SandroGrassia/Belle-Iloise/README.md

# Belle-Iloise
### Project for a midi Talking Drum

this midi controller, that I made in 2017, is designed to be used as a talking drum.
Sound is triggered by tapping on the round pad, the pitch is modulated by squeezing the clothespin.
On the top side, three knobs control the central note, the pitch span and the volume. On the bottom side there is the on/off switch and the MIDI-OUT socket.
The device is powered by two 2x1.5V AA batteries; a small voltage regulator steps the voltage up to 5V required by the circuit.

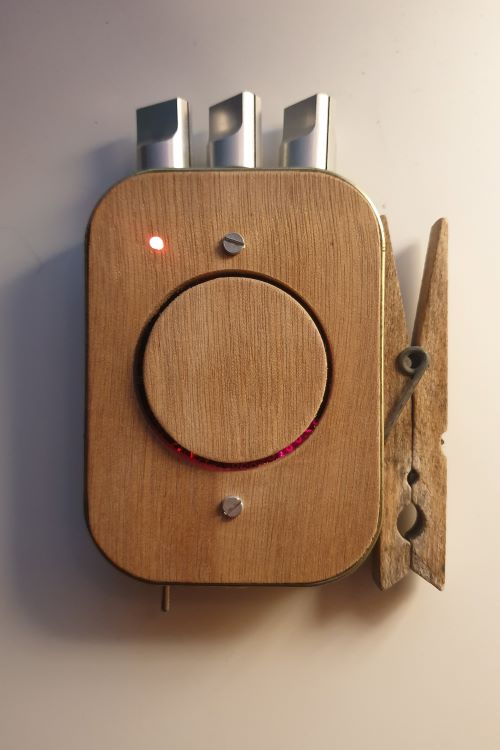
[picture p1: pics/fronte.jpg]


The name comes from the metal case branded "la belle-iloise".

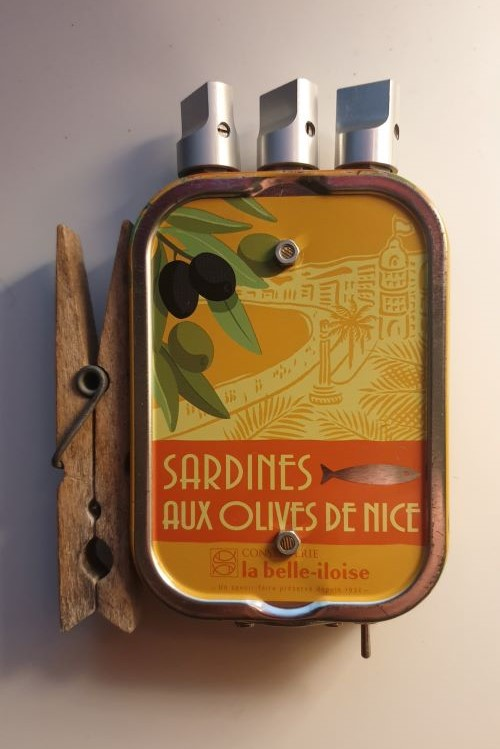
[picture p2: pics/retro.jpg]


This Belle-Iloise was the second piece/version I made, more compact than the previous one; the assembly is very artisanal... And a little bit messy!

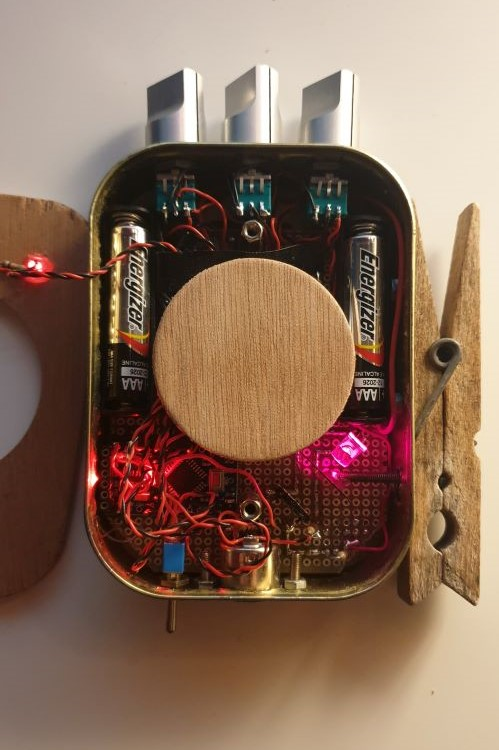
[picture p3: pics/inside.jpg]


This picture shows the Arduino Mini, the small board without USB port, based on an ATmega328P.

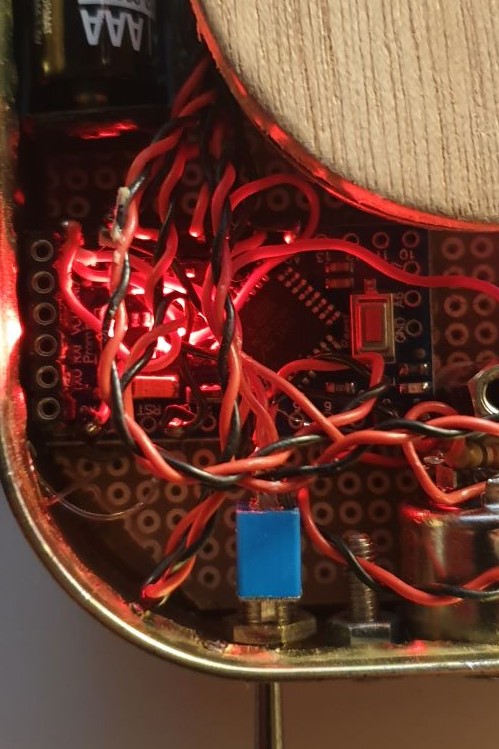
[picture p4: pics/mini.jpg]


*Schematics*

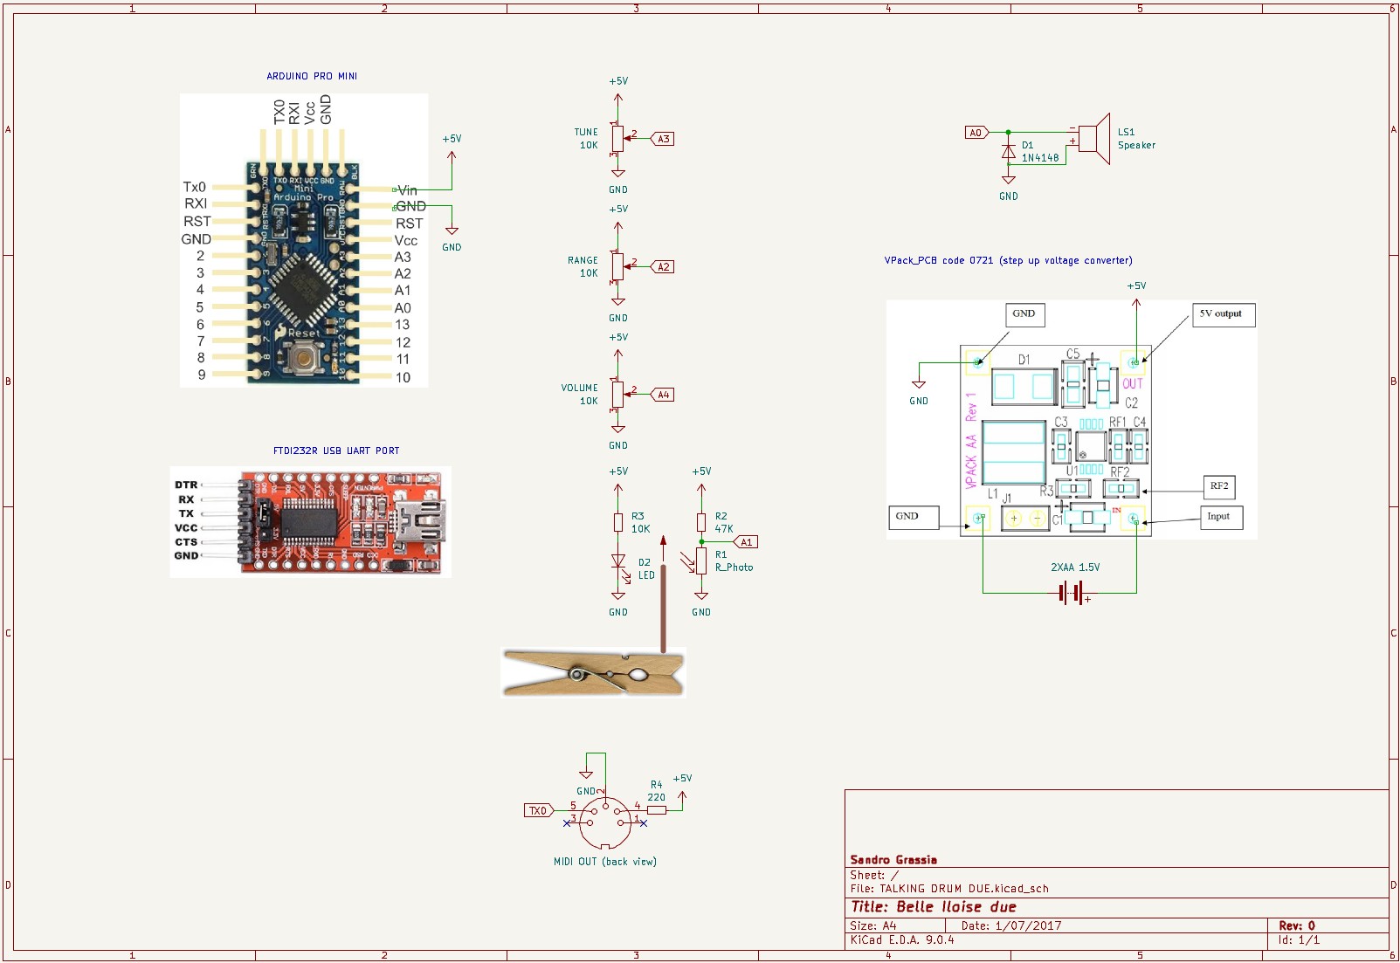
[picture p5: pics/schematics.jpg]
